bonnoa/retrofit_omlet_automatic_door/(commit log)

2026-08-09 fix:publish mqtt / feat.:ssid level
    [web_server_v2.ino]
2026-08-28 fix: discovery mqtt via homeassistant
    fix HA
    add sensor
    [porte_poulailler.ino]
2026-08-28 fix:ha discovery / feat:wifi level dbm
    [web_server_v2.ino]
